trgzng1802/DIGITAL-CLOCK-WITH-7-SEGMENT-DISPLAY/PCB Project/DIGITAL-CLOCK-WITH-7-SEGMENT-DISPLAY/Project Outputs for DIGITAL-CLOCK-WITH-7-SEGMENT-DISPLAY/Pick Place/BOM_MCU_BOARD.xlsx

Designator | Layer | Value
C10 | TopLayer | 10pF, 16V
C11 | TopLayer | 10pF, 16V
C12 | TopLayer | 100nF, 16V
C13 | TopLayer | 1uF, 16V
C14 | TopLayer | 100nF, 16V
C15 | TopLayer | 100nF, 16V
C16 | TopLayer | 1uF, 16V
C2 | TopLayer | 100nF, 16V
C3 | TopLayer | 100nF, 16V
C4 | TopLayer | 4.7uF, 16V
C5 | TopLayer | 100nF, 16V
C6 | TopLayer | 100nF, 16V
C7 | TopLayer | 4.7uF, 16V
C8 | TopLayer | 10nF, 16V
C9 | TopLayer | 1uF, 16V
D8 | TopLayer
D9 | TopLayer
H5 | TopLayer
H6 | TopLayer
IC2 | TopLayer | LM1117
LOGO2 | TopLayer
P3 | TopLayer
P4 | TopLayer
P5 | TopLayer
P6 | TopLayer
R40 | TopLayer | 1K
R41 | BottomLayer | 1K
R42 | BottomLayer | 1K
R43 | TopLayer | 1K
SW1 | TopLayer
U6 | TopLayer
X1 | TopLayer | 8MHz
