trgzng1802/DIGITAL-CLOCK-WITH-7-SEGMENT-DISPLAY/3D Project/Back.SLDASM

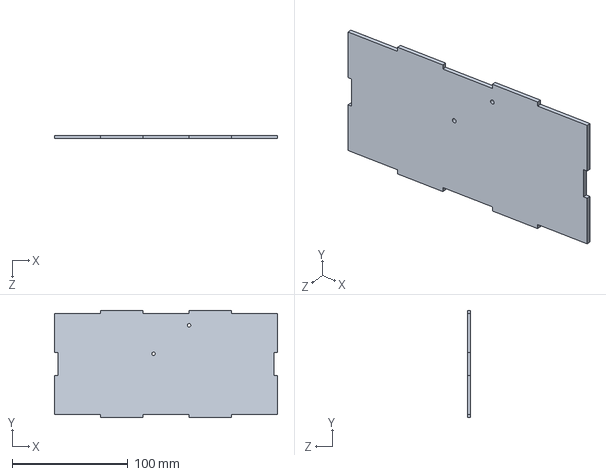
[picture p16: CAD file, 2022-12-19]
3D Project/Back.SLDASM
193.0 x 93.0 x 3.00 mm
