trgzng1802/DIGITAL-CLOCK-WITH-7-SEGMENT-DISPLAY/3D Project/bot.SLDASM

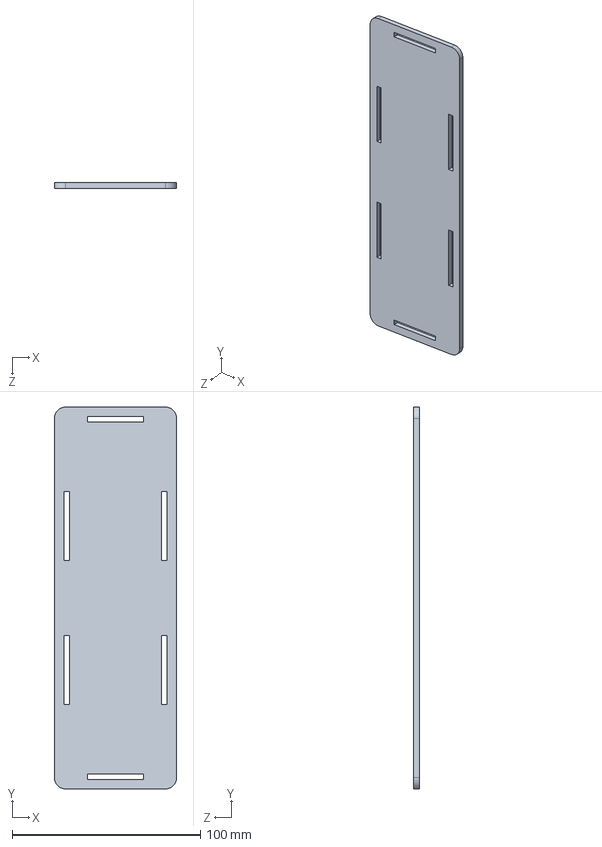
[picture p17: CAD file, 2022-12-19]
3D Project/bot.SLDASM
65.0 x 203.0 x 3.00 mm
