trgzng1802/DIGITAL-CLOCK-WITH-7-SEGMENT-DISPLAY/3D Project/Left.SLDASM

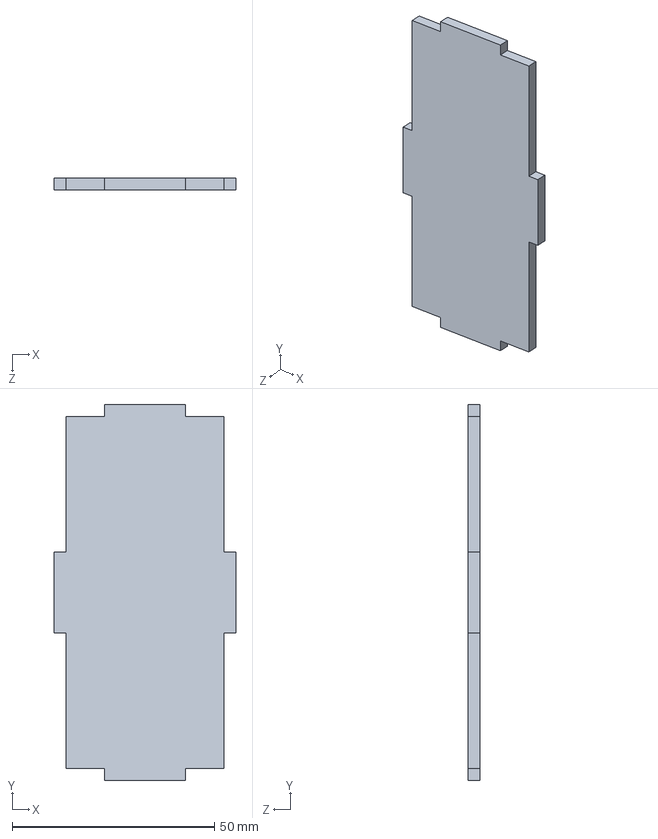
[picture p18: CAD file, 2022-12-19]
3D Project/Left.SLDASM
45.0 x 93.0 x 3.00 mm
