trgzng1802/DIGITAL-CLOCK-WITH-7-SEGMENT-DISPLAY/3D Project/Right.SLDASM

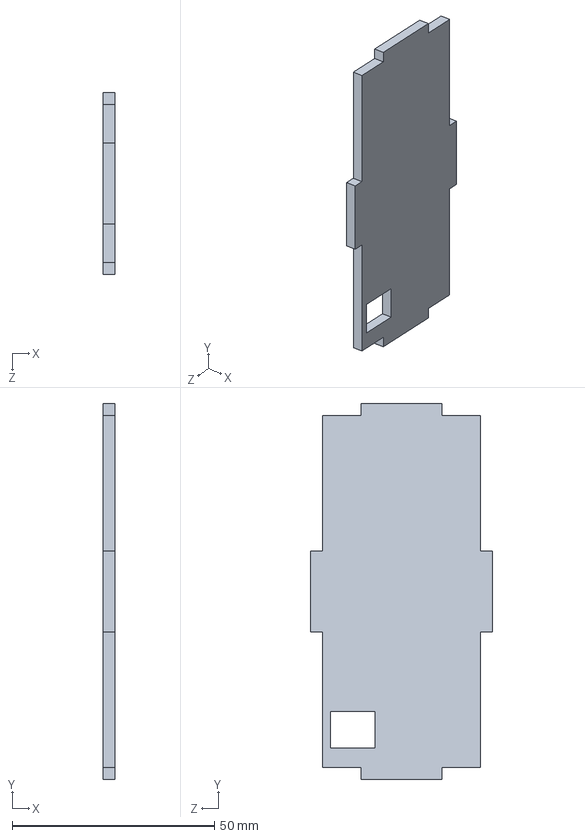
[picture p19: CAD file, 2022-12-19]
3D Project/Right.SLDASM
3.00 x 93.0 x 45.0 mm
