trgzng1802/DIGITAL-CLOCK-WITH-7-SEGMENT-DISPLAY/3D Project/board_mcu.SLDASM

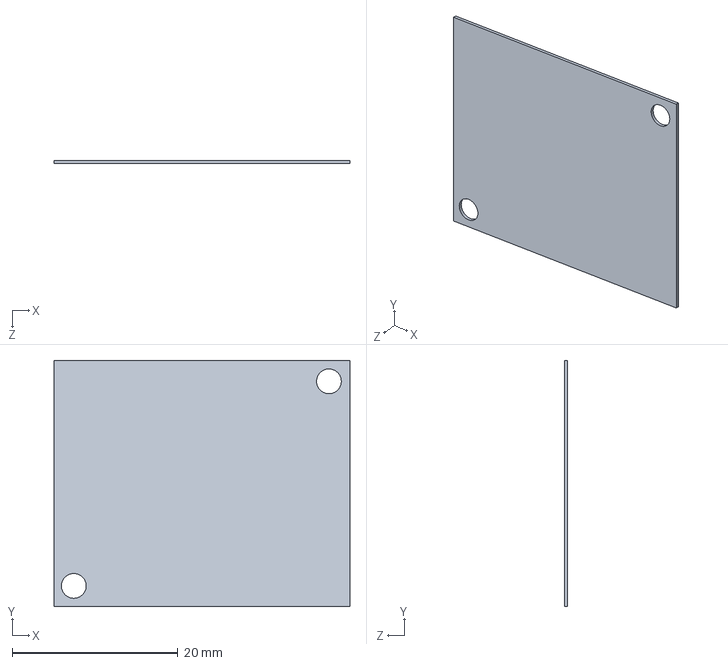
[picture p20: CAD file, 2022-11-21]
3D Project/board_mcu.SLDASM
35.7 x 29.7 x 0.411 mm
