trgzng1802/DIGITAL-CLOCK-WITH-7-SEGMENT-DISPLAY/3D Project/MCU_BOARD.step.SLDASM

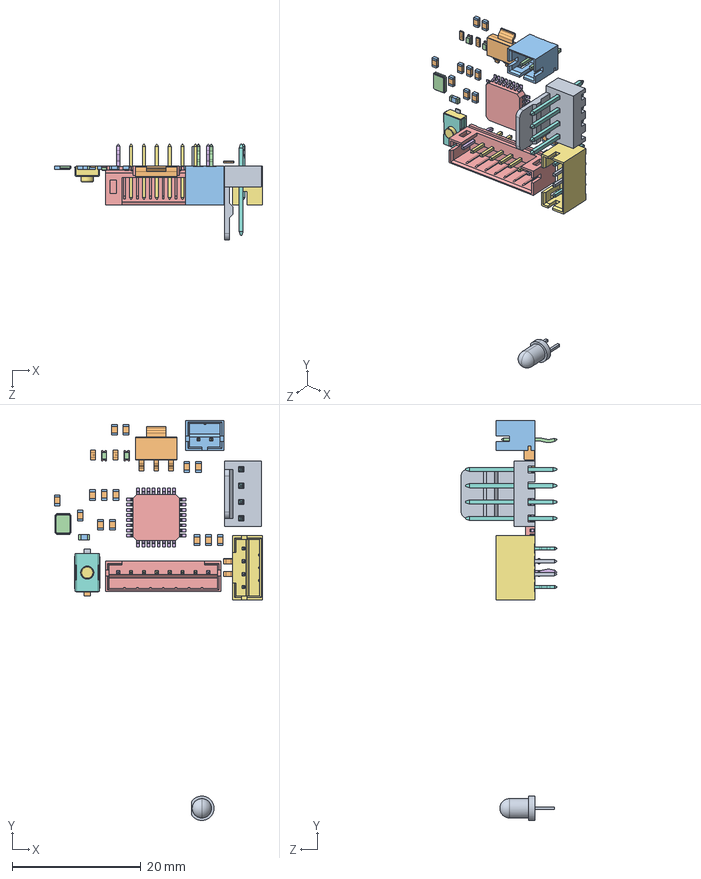
[picture p21: CAD file, 2022-11-21]
3D Project/MCU_BOARD.step.SLDASM
32.4 x 62.2 x 14.9 mm
SW3DPS-LED_DIP_3MM-DEFAULT.step
User_Library-0603_SMD_Capacitor.step x 4
housing.step x 2
cover.step x 2
base.step x 4
Polarity_Mark.step x 2
62000411622-0.step
Pin1.step x 2
Pin2.step x 2
Extruded.step x 14
Extruded-1.step x 28
NX3225SA.step
Open_CASCADE_STEP_translator_6.8_1.1.1.step
Leader.step x 32
base-2.step
top_cover.step
pins.step
pins-3.step
62000211622-4.step
Pin1-5.step x 2
62000811622-6.step
6200xx11622_Pin1.step x 2
6200xx11622_Pin2.step x 6
6190xx11121_PIN.step x 4
61900411121-7.step
SW3dPS-Regulator.step
Extruded-8.step
Extruded-9.step x 2
