trgzng1802/DIGITAL-CLOCK-WITH-7-SEGMENT-DISPLAY/3D Project/mica/Top.DXF

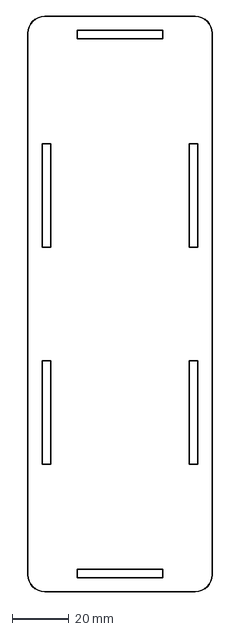
[picture p22: CAD file, 2022-12-19]
3D Project/mica/Top.DXF
65.0 x 203.0 mm
