trgzng1802/DIGITAL-CLOCK-WITH-7-SEGMENT-DISPLAY/3D Project/mica/Bot.DXF

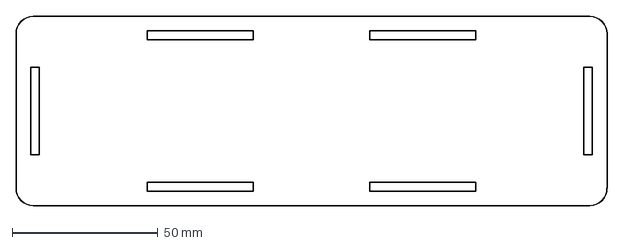
[picture p23: CAD file, 2022-12-19]
3D Project/mica/Bot.DXF
203.0 x 65.0 mm
