trgzng1802/DIGITAL-CLOCK-WITH-7-SEGMENT-DISPLAY/3D Project/mica/Left.DXF

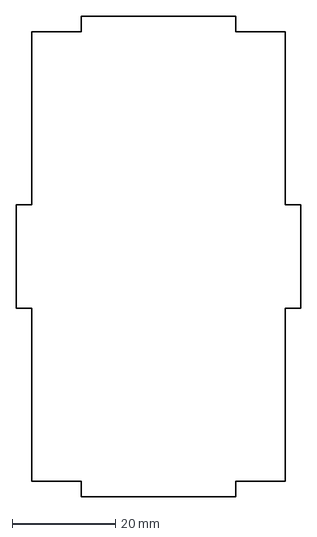
[picture p24: CAD file, 2022-12-19]
3D Project/mica/Left.DXF
55.0 x 93.0 mm
