trgzng1802/DIGITAL-CLOCK-WITH-7-SEGMENT-DISPLAY/3D Project/mica/Front.DXF

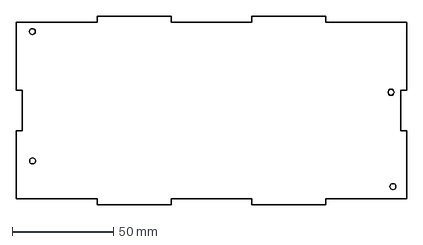
[picture p25: CAD file, 2022-12-19]
3D Project/mica/Front.DXF
193.0 x 93.0 mm
