trgzng1802/DIGITAL-CLOCK-WITH-7-SEGMENT-DISPLAY/3D Project/mica/Back.DXF

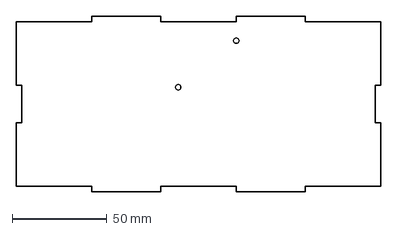
[picture p27: CAD file, 2022-12-19]
3D Project/mica/Back.DXF
193.0 x 93.0 mm
