trgzng1802/DIGITAL-CLOCK-WITH-7-SEGMENT-DISPLAY/3D Project/MCU_BOARD.step

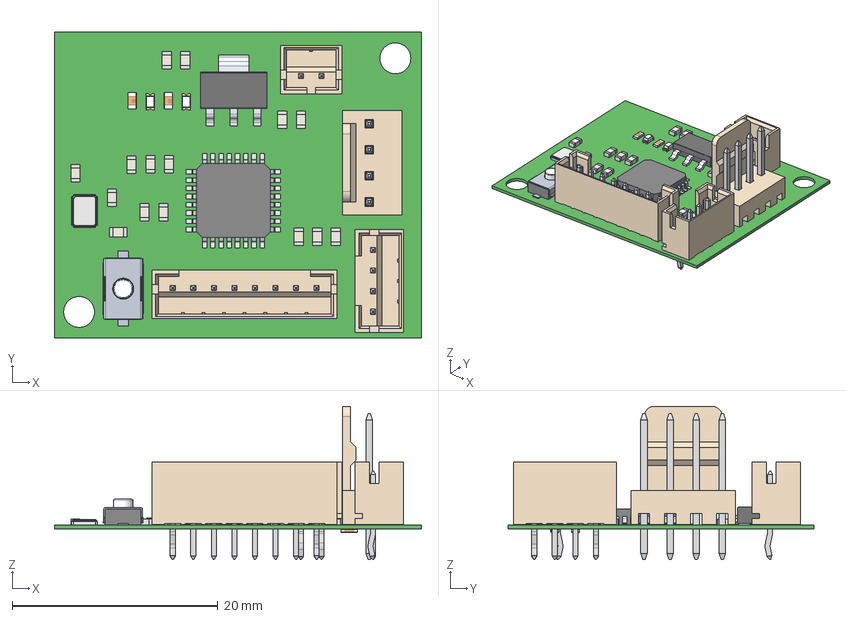
[picture p28: CAD file, 2022-11-21]
3D Project/MCU_BOARD.step
35.7 x 29.7 x 14.9 mm
User_Library-0603_SMD_Capacitor x 4
housing x 2
cover x 2
base x 5
Polarity_Mark x 2
Pin1 x 4
Pin2 x 2
Extruded x 45
NX3225SA
Open_CASCADE_STEP_translator_6.8_1.1.1
Leader x 32
top_cover
pins x 2
6200xx11622_Pin1 x 2
6200xx11622_Pin2 x 6
6190xx11121_PIN x 4
SW3dPS-Regulator
