trgzng1802/DIGITAL-CLOCK-WITH-7-SEGMENT-DISPLAY/(list of files, cad)

Other CAD files:
PCB Project/DIGITAL-CLOCK-WITH-7-SEGMENT-DISPLAY/Top.SLDASM
3D Project/Top.SLDASM
3D Project/R41.step.SLDASM
3D Project/P5.step.SLDASM
3D Project/C14.step.SLDASM
3D Project/C15.step.SLDASM
3D Project/Front.SLDASM
3D Project/C12.step.SLDASM
3D Project/C7.step.SLDASM
3D Project/C4.step.SLDASM
3D Project/C16.step.SLDASM
3D Project/C3.step.SLDASM
3D Project/C8.step.SLDASM
3D Project/P3.step.SLDASM
3D Project/P6.step.SLDASM
3D Project/IC2.step.SLDASM
3D Project/R42.step.SLDASM
3D Project/C9.step.SLDASM
3D Project/C13.step.SLDASM
3D Project/U6.step.SLDASM
3D Project/D8.step.SLDASM
3D Project/Body.step.SLDASM
3D Project/C6.step.SLDASM
3D Project/X1.step.SLDASM
3D Project/P4.step.SLDASM
3D Project/Board.step.SLDASM
3D Project/C10.step.SLDASM
3D Project/SW1.step.SLDASM
3D Project/R40.step.SLDASM
3D Project/R43.step.SLDASM
3D Project/C5.step.SLDASM
3D Project/C11.step.SLDASM
3D Project/C2.step.SLDASM
3D Project/D9.step.SLDASM
3D Project/Pin2.step.SLDPRT
3D Project/Pin1-5.step.SLDPRT
3D Project/Extruded-1.step.SLDPRT
3D Project/cover.step.SLDPRT
3D Project/User_Library-0603_SMD_Capacitor.step.SLDPRT
3D Project/6200xx11622_Pin1.step.SLDPRT
3D Project/Leader.step.SLDPRT
3D Project/SW3dPS-Regulator.step.SLDPRT
3D Project/Polarity_Mark.step.SLDPRT
3D Project/pins-3.step.SLDPRT
3D Project/Extruded.step.SLDPRT
3D Project/Open_CASCADE_STEP_translator_6.8_1.1.1.step.SLDPRT
3D Project/Open CASCADE STEP translator 6.8 7.1.1.step.SLDPRT
3D Project/Extruded-9.step.SLDPRT
3D Project/Extruded-8.step.SLDPRT
3D Project/base-2.step.SLDPRT
3D Project/NX3225SA.step.SLDPRT
3D Project/base.step.SLDPRT
3D Project/pins.step.SLDPRT
3D Project/6200xx11622_Pin2.step.SLDPRT
3D Project/Pin1.step.SLDPRT
3D Project/housing.step.SLDPRT
3D Project/6190xx11121_PIN.step.SLDPRT
3D Project/top_cover.step.SLDPRT
3D Project/150060xxx.step.SLDASM
3D Project/4341x10258xx.step.SLDASM
3D Project/61900411121-7.step.SLDPRT
3D Project/61900411121.step.SLDASM
3D Project/62000211622-4.step.SLDPRT
3D Project/62000211622.step.SLDASM
3D Project/62000411622-0.step.SLDPRT
3D Project/62000411622.step.SLDASM
3D Project/62000811622-6.step.SLDPRT
3D Project/62000811622.step.SLDASM
3D Project/6595582960.step.SLDASM
3D Project/6639957632.step.SLDASM
3D Project/6639957792.step.SLDASM
3D Project/6640542560.step.SLDASM
3D Project/6640542880.step.SLDASM
3D Project/Back.DXF
3D Project/Back.SLDPRT
3D Project/Bot.DXF
3D Project/Bot.SLDPRT
3D Project/Front.DXF
3D Project/Front.SLDPRT
3D Project/Left.DXF
3D Project/Left.SLDPRT
3D Project/MCU_BOARD_.step
3D Project/MCU_BOARD_.step.SLDPRT
3D Project/Right.DXF
3D Project/Right.SLDPRT
3D Project/Top.DXF
3D Project/Top.SLDPRT
