trgzng1802/DIGITAL-CLOCK-WITH-7-SEGMENT-DISPLAY/PCB Project/DIGITAL-CLOCK-WITH-7-SEGMENT-DISPLAY/Project Outputs for DIGITAL-CLOCK-WITH-7-SEGMENT-DISPLAY/MCU_CLOCK_SCH.PDF

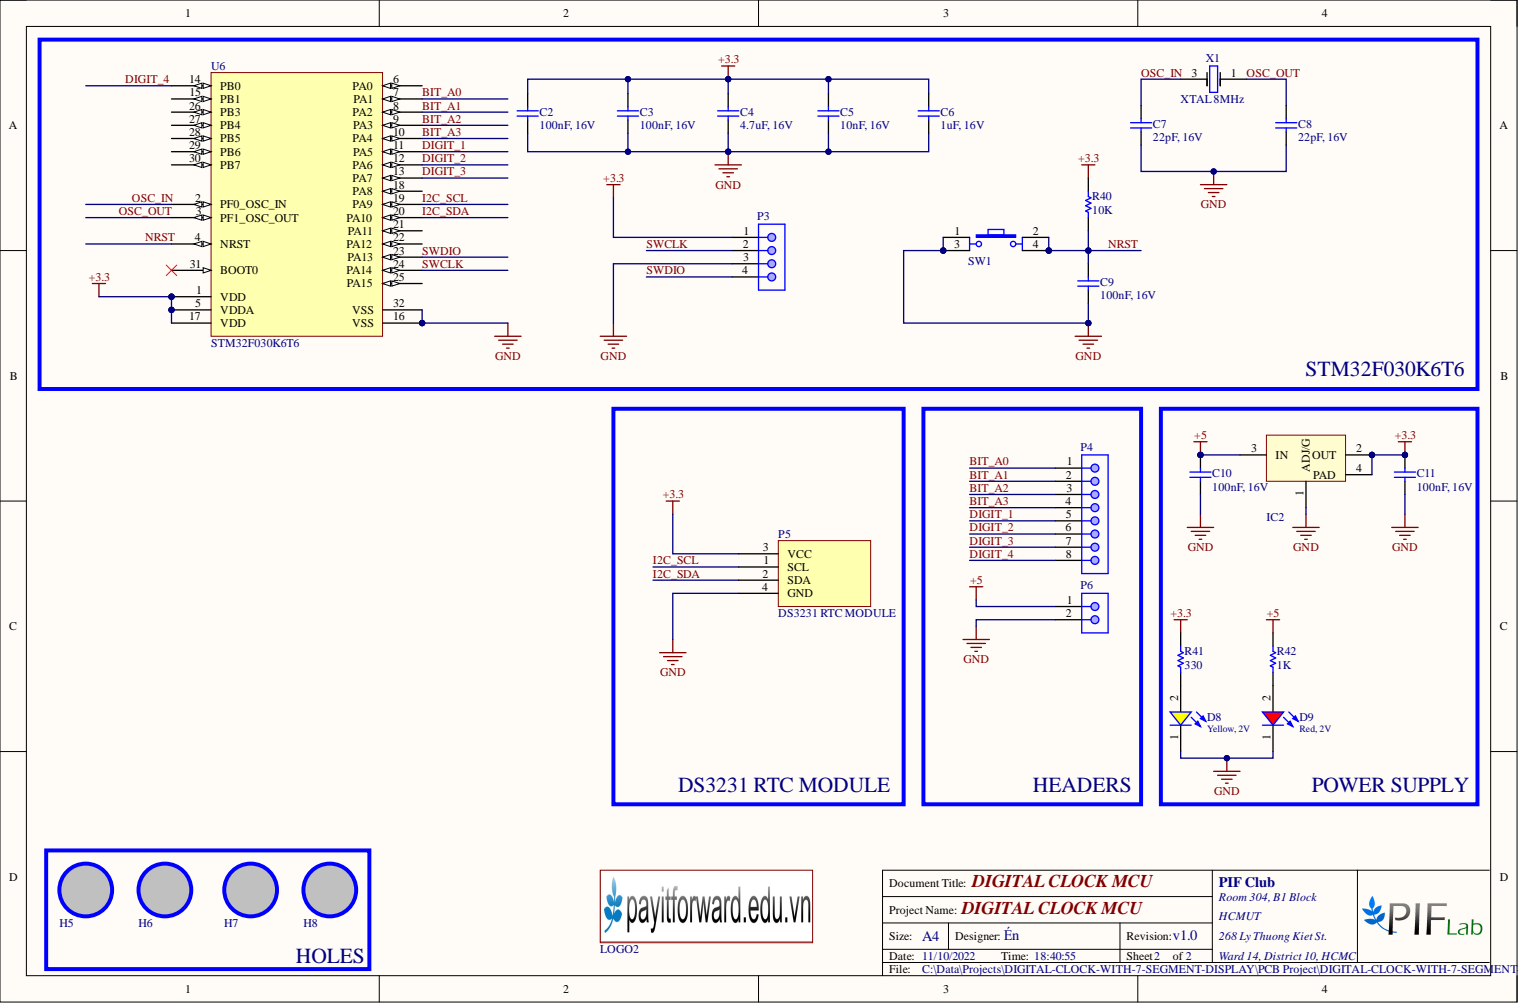
[picture p29: page 1]

Document Title:
Project Name: DIGITAL CLOCK MCU

PIF Club Room 304, B1 Block

C:\Data\Projects\DIGITAL-CLOCK-WITH-7-SEGMENT-DISPLAY\PCB Project\DIGITAL-CLOCK-WITH-7-SEGMENT-DISPLAY\CONTROL-PANEL.SchDoc
