trgzng1802/DIGITAL-CLOCK-WITH-7-SEGMENT-DISPLAY/PCB Project/DIGITAL-CLOCK-WITH-7-SEGMENT-DISPLAY/Project Outputs for DIGITAL-CLOCK-WITH-7-SEGMENT-DISPLAY/DIGITAL-CLOCK-SCHPDF.PDF

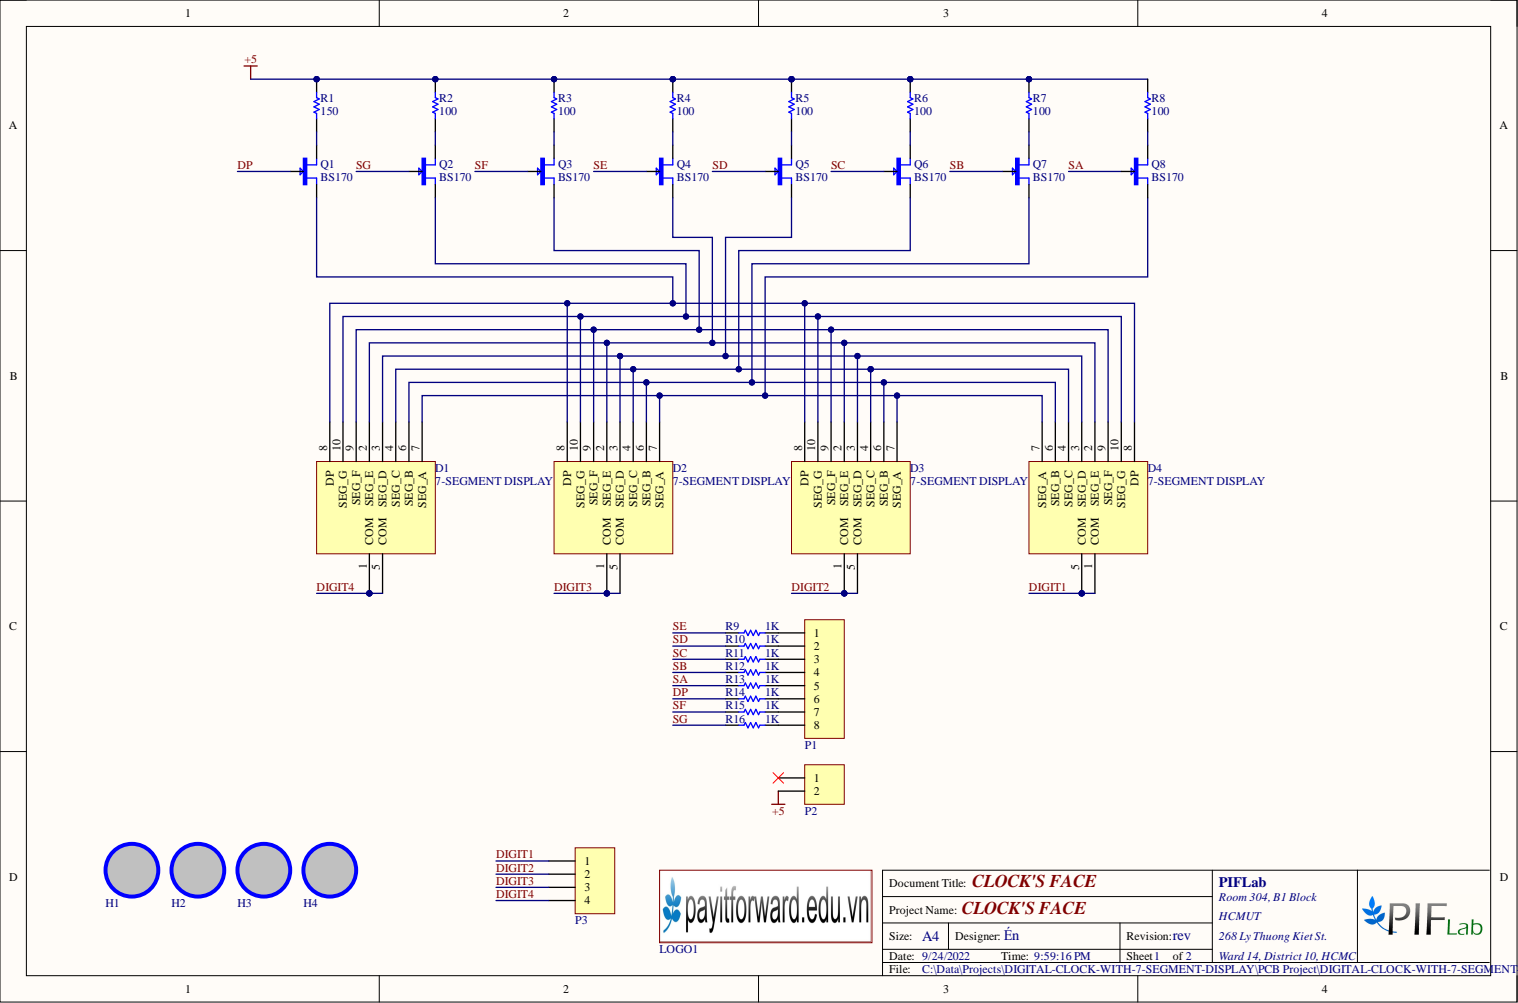
[picture p30: page 1]

Project Name: CLOCK'S FACE

C:\Data\Projects\DIGITAL-CLOCK-WITH-7-SEGMENT-DISPLAY\PCB Project\DIGITAL-CLOCK-WITH-7-SEGMENT-DISPLAY\7-SEGMENT_DISPLAY_4_DIGITS.SchDoc
