trgzng1802/DIGITAL-CLOCK-WITH-7-SEGMENT-DISPLAY/PCB Project/BOARD.pdf

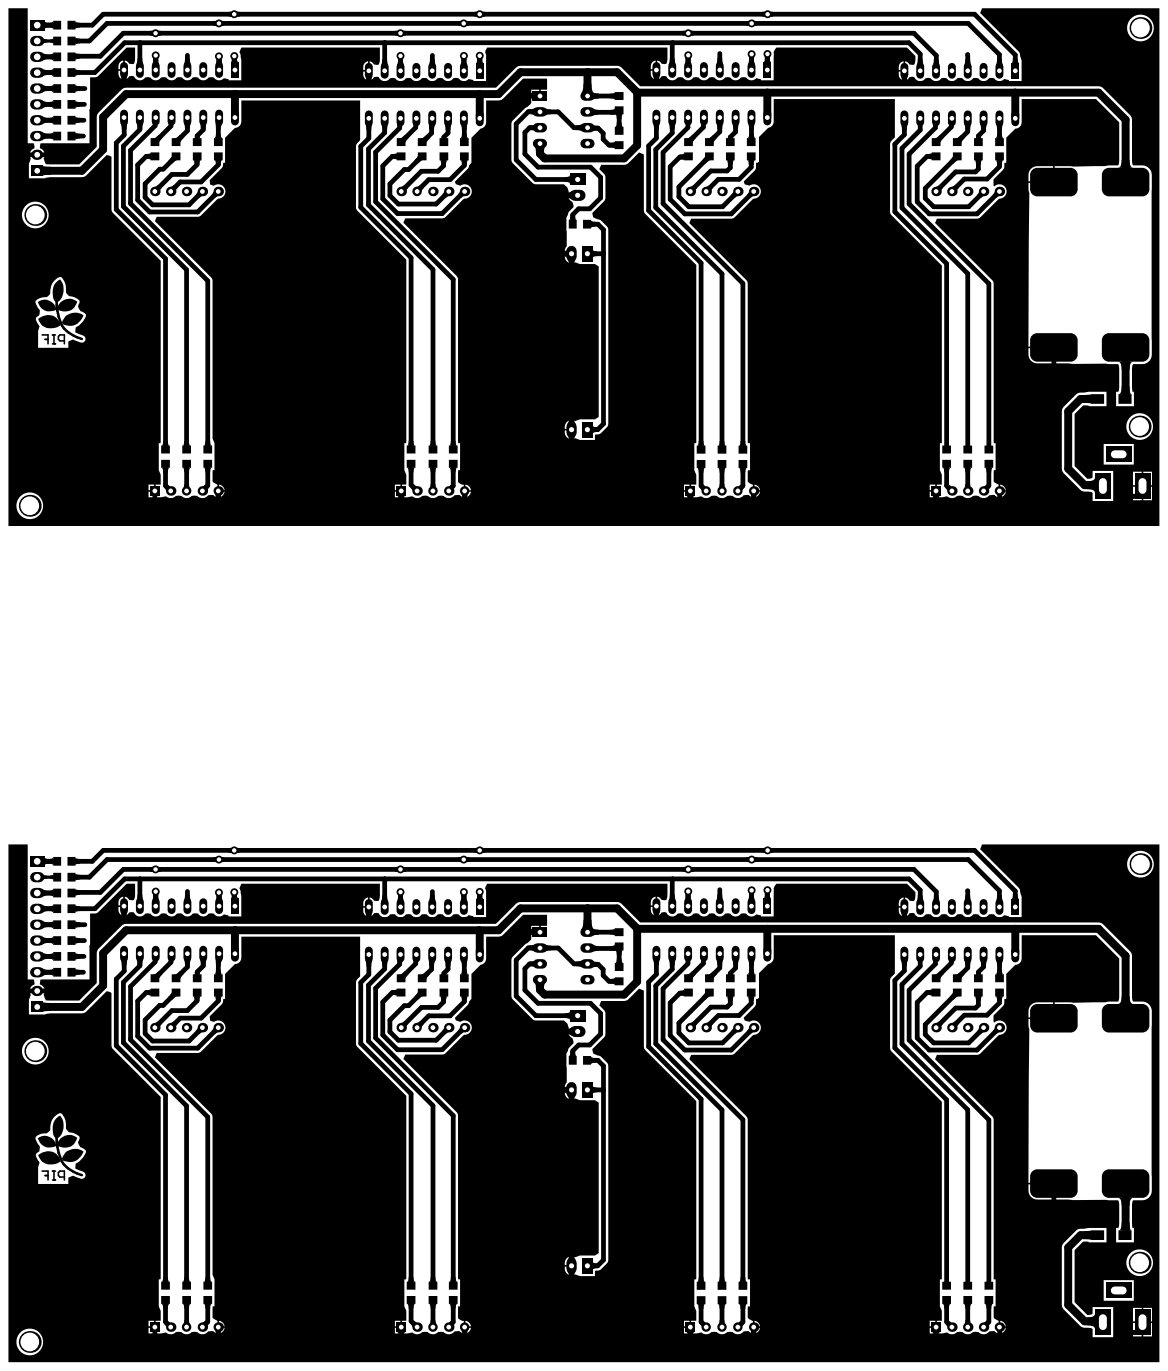
[picture p31: page 1]
