trgzng1802/DIGITAL-CLOCK-WITH-7-SEGMENT-DISPLAY/PCB Project/DIGITAL-CLOCK.pdf

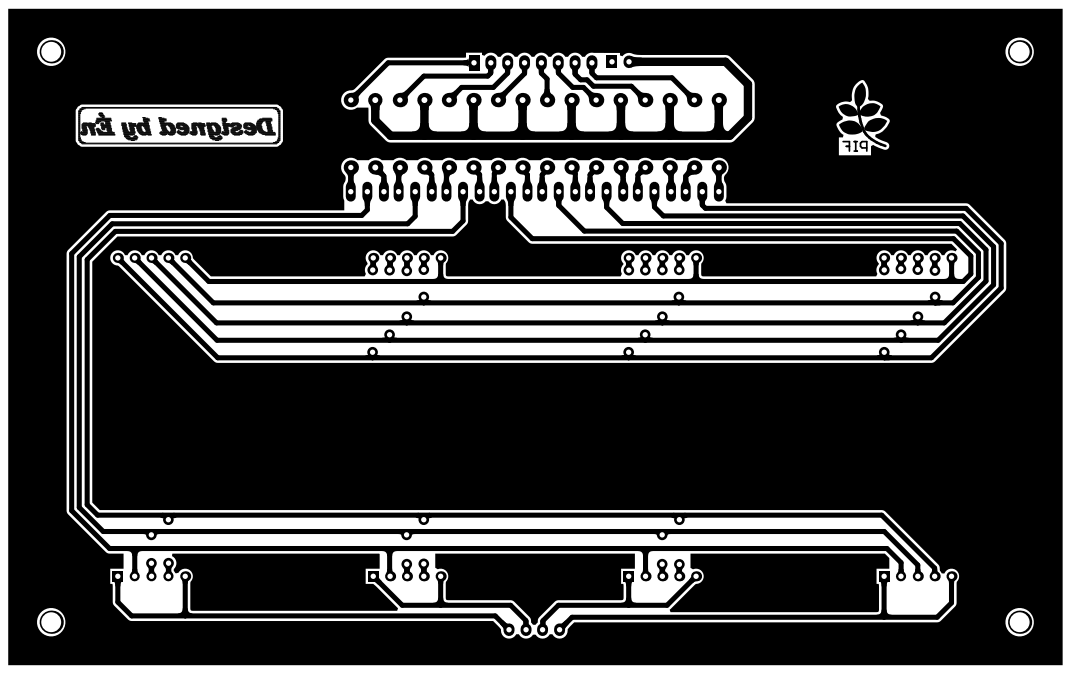
[picture p32: page 1]
