trgzng1802/DIGITAL-CLOCK-WITH-7-SEGMENT-DISPLAY/Firezen Clock/Firezen Clock/dong ho so _layout.pdf

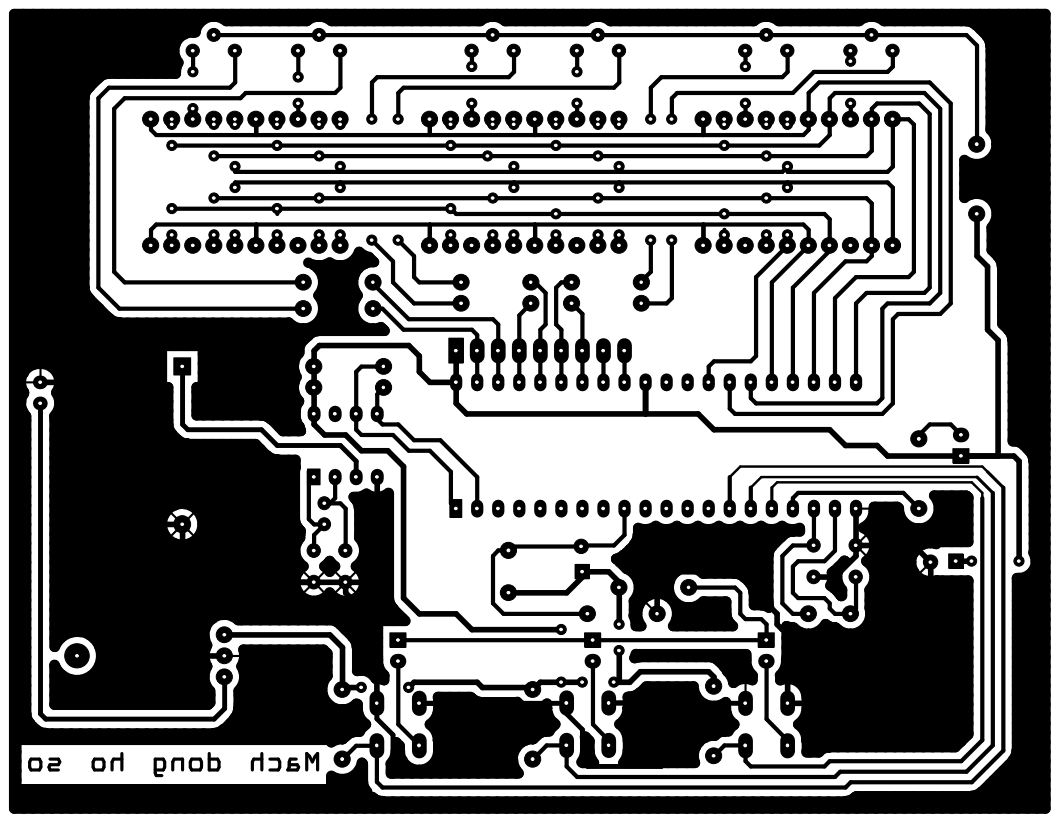
[picture p33: page 1]
