trgzng1802/DIGITAL-CLOCK-WITH-7-SEGMENT-DISPLAY/PCB Project/DIGITAL-CLOCK-WITH-7-SEGMENT-DISPLAY/Project Outputs for DIGITAL-CLOCK-WITH-7-SEGMENT-DISPLAY/Job1.PDF

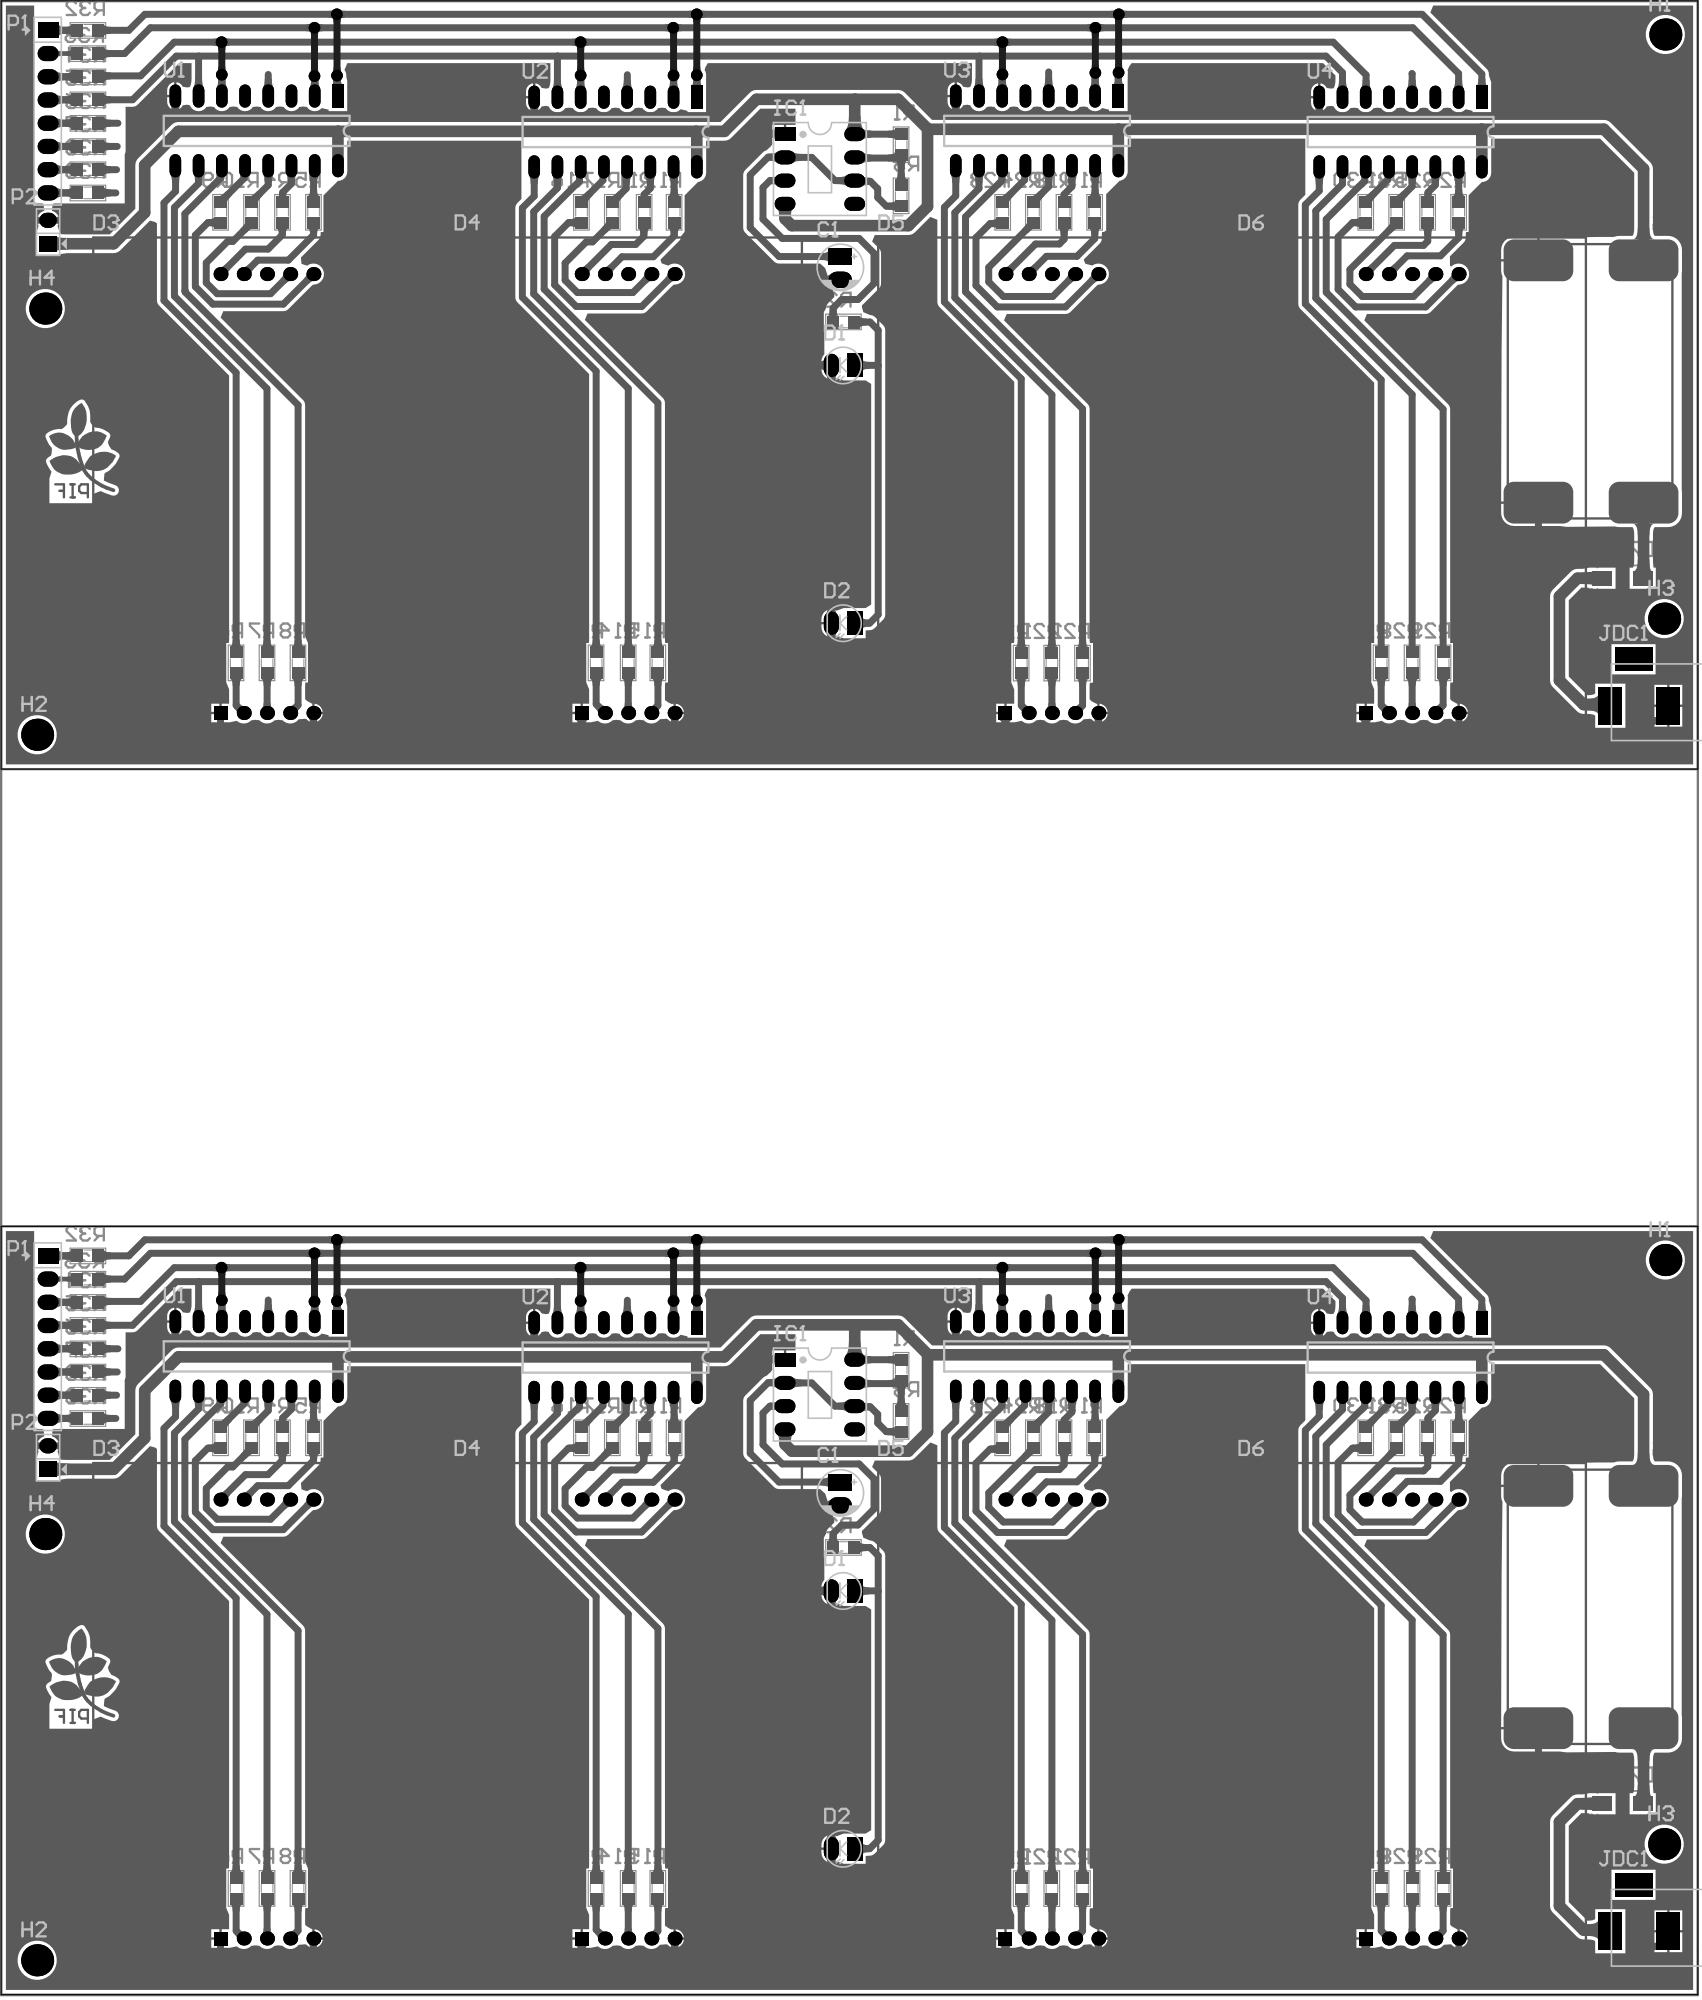
[picture p34: page 1]
