trgzng1802/DIGITAL-CLOCK-WITH-7-SEGMENT-DISPLAY/(list of files, drawings)

Other design files:
PCB Project/DIGITAL-CLOCK-WITH-7-SEGMENT-DISPLAY/7-SEGMENT_DISPLAY_4_DIGITS.PcbDoc
PCB Project/DIGITAL-CLOCK-WITH-7-SEGMENT-DISPLAY/7-SEGMENT_DISPLAY_4_DIGITS.SchDoc
PCB Project/DIGITAL-CLOCK-WITH-7-SEGMENT-DISPLAY/BOARD-PANEL.PcbDoc
PCB Project/DIGITAL-CLOCK-WITH-7-SEGMENT-DISPLAY/CONTROL-PANEL.SchDoc
PCB Project/DIGITAL-CLOCK-WITH-7-SEGMENT-DISPLAY/DIGITAL-CLOCK-WITH-7-SEGMENT-DISPLAY.PrjPcb
PCB Project/DIGITAL-CLOCK-WITH-7-SEGMENT-DISPLAY/MCU_BOARD.PcbDoc
PCB Project/DIGITAL-CLOCK-WITH-7-SEGMENT-DISPLAY/MCU_PANEL.PcbDoc
