trgzng1802/DIGITAL-CLOCK-WITH-7-SEGMENT-DISPLAY/Code STM32/Core/Src/main.c

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
/* Includes ------------------------------------------------------------------*/
#include "main.h"

/* USER CODE BEGIN PD */
#define DS3231_ADDRESS 0xD0
/* USER CODE END PD */

I2C_HandleTypeDef hi2c1;

TIM_HandleTypeDef htim3;
TIM_HandleTypeDef htim14;

/* USER CODE BEGIN PV */
typedef struct {
	int hour;
	int minute;
	int month;
	int dom;
	int dow;
} timeData_t;

typedef struct {
	uint8_t Digit1;
	uint8_t Digit2;
	uint8_t Digit3;
	uint8_t Digit4;
} digit_t;

typedef enum {
	hour_n_minute,
	day_of_week,
	date_n_month,
} timeComponent_t;

timeComponent_t timeComponent = 0;
timeData_t timeNow;
digit_t timeDigit;
uint32_t sweepTime = 0;
uint8_t digit = 1;
uint8_t flag = 1;
int count = 0;
/* USER CODE END PV */

void SystemClock_Config(void);
static void MX_GPIO_Init(void);
static void MX_I2C1_Init(void);
static void MX_TIM3_Init(void);
static void MX_TIM14_Init(void);
/* USER CODE BEGIN PFP */
uint8_t decToBcd(int val);
int bcdToDec(uint8_t val);
void Set_Time (uint8_t sec, uint8_t min, uint8_t hour, uint8_t dow, uint8_t dom, uint8_t month, uint8_t year);
void Get_Time (void);
void Display_Time(void);
/* USER CODE END PFP */

/* USER CODE BEGIN 0 */
void HAL_TIM_PeriodElapsedCallback(TIM_HandleTypeDef *htim)
{
  if (htim->Instance == htim3.Instance) flag = 1;
  if (htim->Instance == htim14.Instance){
	  if (timeComponent == 2) timeComponent = 0;
	  else timeComponent++;
  }
}
// Convert normal decimal numbers to binary coded decimal
uint8_t decToBcd(int val)
{
  return (uint8_t)( (val/10*16) + (val%10) );
}
// Convert binary coded decimal to normal decimal numbers
int bcdToDec(uint8_t val)
{
  return (int)( (val/16*10) + (val%16) );
}
/* function to set time */

void Set_Time (uint8_t sec, uint8_t min, uint8_t hour, uint8_t dow, uint8_t dom, uint8_t month, uint8_t year)
{
	uint8_t set_time[7];
	set_time[0] = decToBcd(sec);
	set_time[1] = decToBcd(min);
	set_time[2] = decToBcd(hour);
	set_time[3] = decToBcd(dow);
	set_time[4] = decToBcd(dom);
	set_time[5] = decToBcd(month);
	set_time[6] = decToBcd(year);

	HAL_I2C_Mem_Write(&hi2c1, DS3231_ADDRESS, 0x00, 1, set_time, 7, 1000);
}
//function to get time
void Get_Time (void)
{
	uint8_t get_time[6];
	HAL_I2C_Mem_Read(&hi2c1, DS3231_ADDRESS, 0x01, 1, get_time, 6, 1000);
	timeNow.minute = bcdToDec(get_time[0]);
	timeNow.hour = bcdToDec(get_time[1]);
	timeNow.dow = bcdToDec(get_time[2]);
	timeNow.dom = bcdToDec(get_time[3]);
	timeNow.month = bcdToDec(get_time[4]);
	switch (timeComponent) {
		case hour_n_minute: {
			timeDigit.Digit1 = decToBcd((timeNow.hour/10));
			timeDigit.Digit2 = decToBcd((timeNow.hour%10));
			timeDigit.Digit3 = decToBcd((timeNow.minute/10));
			timeDigit.Digit4 = decToBcd((timeNow.minute%10));
			break;
		}
		case date_n_month: {
			timeDigit.Digit1 = decToBcd((timeNow.dom/10));
			timeDigit.Digit2 = decToBcd((timeNow.dom%10));
			timeDigit.Digit3 = decToBcd((timeNow.month/10));
			timeDigit.Digit4 = decToBcd((timeNow.month%10));
			break;
		}
		case day_of_week: {
			timeDigit.Digit1 = 0b1111;
			timeDigit.Digit2 = 0b1111;
			timeDigit.Digit3 = 0b1110;
			timeDigit.Digit4 = (timeNow.dow == 1) ? 0b1000 : decToBcd(timeNow.dow);
			break;
		}
		default: break;
	}
}

void Display_Time(void)
{
	Get_Time();
	switch(digit){
			case 1:
				if(flag){
					HAL_GPIO_WritePin(DIGIT_1_GPIO_Port, DIGIT_1_Pin, 1);
					HAL_GPIO_WritePin(DIGIT_2_GPIO_Port, DIGIT_2_Pin, 0);
					HAL_GPIO_WritePin(DIGIT_3_GPIO_Port, DIGIT_3_Pin, 0);
					HAL_GPIO_WritePin(DIGIT_4_GPIO_Port, DIGIT_4_Pin, 0);
					HAL_GPIO_WritePin(BIT_A3_GPIO_Port, BIT_A3_Pin, timeDigit.Digit1 & 0b0001);
					HAL_GPIO_WritePin(BIT_A0_GPIO_Port, BIT_A0_Pin, timeDigit.Digit1 & 0b0010);
					HAL_GPIO_WritePin(BIT_A1_GPIO_Port, BIT_A1_Pin, timeDigit.Digit1 & 0b0100);
					HAL_GPIO_WritePin(BIT_A2_GPIO_Port, BIT_A2_Pin, timeDigit.Digit1 & 0b1000);
					digit = 2;
					flag = 0;
				}
				break;
			case 2:
				if(flag){
					HAL_GPIO_WritePin(DIGIT_2_GPIO_Port, DIGIT_2_Pin, 1);
					HAL_GPIO_WritePin(DIGIT_1_GPIO_Port, DIGIT_1_Pin, 0);
					HAL_GPIO_WritePin(DIGIT_3_GPIO_Port, DIGIT_3_Pin, 0);
					HAL_GPIO_WritePin(DIGIT_4_GPIO_Port, DIGIT_4_Pin, 0);
					HAL_GPIO_WritePin(BIT_A3_GPIO_Port, BIT_A3_Pin, timeDigit.Digit2 & 0b0001);
					HAL_GPIO_WritePin(BIT_A0_GPIO_Port, BIT_A0_Pin, timeDigit.Digit2 & 0b0010);
					HAL_GPIO_WritePin(BIT_A1_GPIO_Port, BIT_A1_Pin, timeDigit.Digit2 & 0b0100);
					HAL_GPIO_WritePin(BIT_A2_GPIO_Port, BIT_A2_Pin, timeDigit.Digit2 & 0b1000);
					digit = 3;
					flag = 0;
				}
				break;
			case 3:
				if(flag){
					HAL_GPIO_WritePin(DIGIT_3_GPIO_Port, DIGIT_3_Pin, 1);
					HAL_GPIO_WritePin(DIGIT_1_GPIO_Port, DIGIT_1_Pin, 0);
					HAL_GPIO_WritePin(DIGIT_2_GPIO_Port, DIGIT_2_Pin, 0);
					HAL_GPIO_WritePin(DIGIT_4_GPIO_Port, DIGIT_4_Pin, 0);
					HAL_GPIO_WritePin(BIT_A3_GPIO_Port, BIT_A3_Pin, timeDigit.Digit3 & 0b0001);
					HAL_GPIO_WritePin(BIT_A0_GPIO_Port, BIT_A0_Pin, timeDigit.Digit3 & 0b0010);
					HAL_GPIO_WritePin(BIT_A1_GPIO_Port, BIT_A1_Pin, timeDigit.Digit3 & 0b0100);
					HAL_GPIO_WritePin(BIT_A2_GPIO_Port, BIT_A2_Pin, timeDigit.Digit3 & 0b1000);
					digit = 4;
					flag = 0;
				}
				break;
			case 4:
				if(flag){
					HAL_GPIO_WritePin(DIGIT_4_GPIO_Port, DIGIT_4_Pin, 1);
					HAL_GPIO_WritePin(DIGIT_1_GPIO_Port, DIGIT_1_Pin, 0);
					HAL_GPIO_WritePin(DIGIT_2_GPIO_Port, DIGIT_2_Pin, 0);
					HAL_GPIO_WritePin(DIGIT_3_GPIO_Port, DIGIT_3_Pin, 0);
					HAL_GPIO_WritePin(BIT_A3_GPIO_Port, BIT_A3_Pin, timeDigit.Digit4 & 0b0001);
					HAL_GPIO_WritePin(BIT_A0_GPIO_Port, BIT_A0_Pin, timeDigit.Digit4 & 0b0010);
					HAL_GPIO_WritePin(BIT_A1_GPIO_Port, BIT_A1_Pin, timeDigit.Digit4 & 0b0100);
					HAL_GPIO_WritePin(BIT_A2_GPIO_Port, BIT_A2_Pin, timeDigit.Digit4 & 0b1000);
					digit = 1;
					flag = 0;
				}
				break;
	}
}
/* USER CODE END 0 */

/**
  * @brief  The application entry point.
  * @retval int
  */
int main(void)
{
  /* MCU Configuration--------------------------------------------------------*/

  /* Reset of all peripherals, Initializes the Flash interface and the Systick. */
  HAL_Init();

  /* Configure the system clock */
  SystemClock_Config();

  /* Initialize all configured peripherals */
  MX_GPIO_Init();
  MX_I2C1_Init();
  MX_TIM3_Init();
  MX_TIM14_Init();
  /* USER CODE BEGIN 2 */
//  Set_Time(30, 35, 16, 7, 26, 11, 22);
  HAL_TIM_Base_Start_IT(&htim3);
  HAL_TIM_Base_Start_IT(&htim14);
  /* USER CODE END 2 */

  /* Infinite loop */
  /* USER CODE BEGIN WHILE */
  while (1)
  {
    /* USER CODE END WHILE */

    /* USER CODE BEGIN 3 */
	  Display_Time();
  }
  /* USER CODE END 3 */
}

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
