trgzng1802/DIGITAL-CLOCK-WITH-7-SEGMENT-DISPLAY/Code STM32/Core/Inc/main.h

#define BIT_A0_Pin GPIO_PIN_1
#define BIT_A0_GPIO_Port GPIOA
#define BIT_A1_Pin GPIO_PIN_2
#define BIT_A1_GPIO_Port GPIOA
#define BIT_A2_Pin GPIO_PIN_3
#define BIT_A2_GPIO_Port GPIOA
#define BIT_A3_Pin GPIO_PIN_4
#define BIT_A3_GPIO_Port GPIOA
#define DIGIT_1_Pin GPIO_PIN_5
#define DIGIT_1_GPIO_Port GPIOA
#define DIGIT_2_Pin GPIO_PIN_6
#define DIGIT_2_GPIO_Port GPIOA
#define DIGIT_3_Pin GPIO_PIN_7
#define DIGIT_3_GPIO_Port GPIOA
#define DIGIT_4_Pin GPIO_PIN_0
#define DIGIT_4_GPIO_Port GPIOB
#define LED_LIFE_Pin GPIO_PIN_7
#define LED_LIFE_GPIO_Port GPIOB
