trgzng1802/DIGITAL-CLOCK-WITH-7-SEGMENT-DISPLAY/(commit log)

2022-09-07 update pcb
2022-09-08 update pcb clock face
    [7-SEGMENT_DISPLAY_4_DIGITS.PcbDoc, 7-SEGMENT_DISPLAY_4_DIGITS.SchDoc, DIGITAL-CLOCK-WITH-7-SEGMENT-DISPLAY.PrjPcb]
2022-09-10 update pcb v1.1
    [7-SEGMENT_DISPLAY_4_DIGITS.PcbDoc, BOARD-PANEL.PcbDoc, CONTROL-PANEL.SchDoc, DIGITAL-CLOCK-WITH-7-SEGMENT-DISPLAY.PrjPcb]
2022-09-11 update pcb v1.3
    [7-SEGMENT_DISPLAY_4_DIGITS.PcbDoc]
2022-09-24 update pcb v1.5
    [7-SEGMENT_DISPLAY_4_DIGITS.PcbDoc, 7-SEGMENT_DISPLAY_4_DIGITS.SchDoc, DIGITAL-CLOCK-WITH-7-SEGMENT-DISPLAY.PrjPcb]
2022-10-01 lai tu dau nao
    [7-SEGMENT_DISPLAY_4_DIGITS.PcbDoc, DIGITAL-CLOCK-WITH-7-SEGMENT-DISPLAY.PrjPcb]
2022-10-02 update pcb v2.1
    [7-SEGMENT_DISPLAY_4_DIGITS.PcbDoc, 7-SEGMENT_DISPLAY_4_DIGITS.SchDoc, BOARD-PANEL.PcbDoc, DIGITAL-CLOCK-WITH-7-SEGMENT-DISPLAY.PrjPcb]
2022-10-09 board chip stm32f030k6t6
    [CONTROL-PANEL.SchDoc]
2022-10-11 update mcu board v1.2
    [CONTROL-PANEL.SchDoc, DIGITAL-CLOCK-WITH-7-SEGMENT-DISPLAY.PrjPcb, MCU_BOARD.PcbDoc]
2022-10-13 update pcd v1.2
    [CONTROL-PANEL.SchDoc, MCU_BOARD.PcbDoc]
2022-10-14 update pcb + gerber
    [CONTROL-PANEL.SchDoc, DIGITAL-CLOCK-WITH-7-SEGMENT-DISPLAY.PrjPcb, MCU_BOARD.PcbDoc, MCU_BOARD.step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]
2022-10-15 update pcb + 3d
    [7-SEGMENT_DISPLAY_4_DIGITS.PcbDoc, DIGITAL-CLOCK-WITH-7-SEGMENT-DISPLAY.PrjPcb, Front.SLDPRT, Left.SLDPRT]
2022-12-01 hiển thị thêm ngày tháng
2022-12-01 update box
    [Back.DXF, Back.SLDASM, Bot.DXF, Bot.SLDPRT, Front.DXF, Left.DXF, Left.SLDASM, Right.DXF]
2022-12-19 update mica
    [Back.DXF, Back.SLDASM, Bot.DXF, Front.DXF, Left.DXF, Left.SLDASM, Right.DXF, Right.SLDASM]
