trgzng1802/DIGITAL-CLOCK-WITH-7-SEGMENT-DISPLAY/(notices)

Notices in the files:
Code STM32/Core/Src/main.c:
Copyright (c) 2022 STMicroelectronics.
All rights reserved.
This software is licensed under terms that can be found in the LICENSE file
